ZexingGao/SeniorDesign/Supporting Documents/All Images/map.png

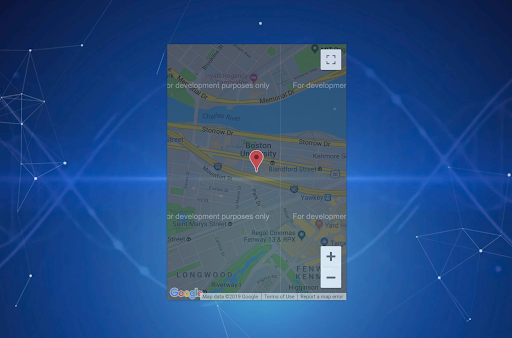
Supporting Documents/All Images/map.png
