ZexingGao/SeniorDesign/Supporting Documents/All Images/IMG_1205.JPG

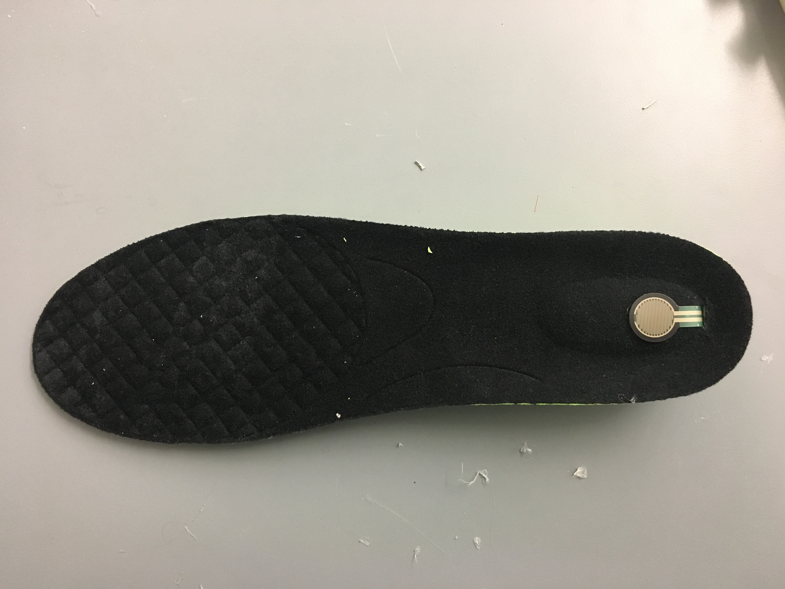
Supporting Documents/All Images/IMG_1205.JPG
