ZexingGao/SeniorDesign/Supporting Documents/Shark Tank Template.pptx

Running Safety

Safety with every Stride

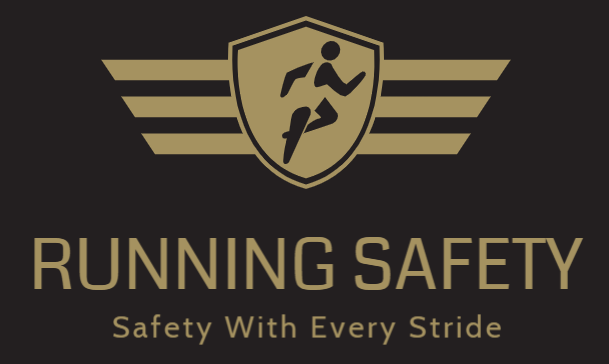
[picture p22: figure]

## Value Proposition

Who is this for?
Our product is design for night runner, especially women.
What does it provide?
The RunningSafety+ is a self-working device that provides it’s user safe running experience.
Advantage?
Unlike RunAngel, a bracelet that can send alert message by pressing the center button, RunningSafety+ can automatically detect danger and send out SOS messages without any action from the runner.

## Visualization

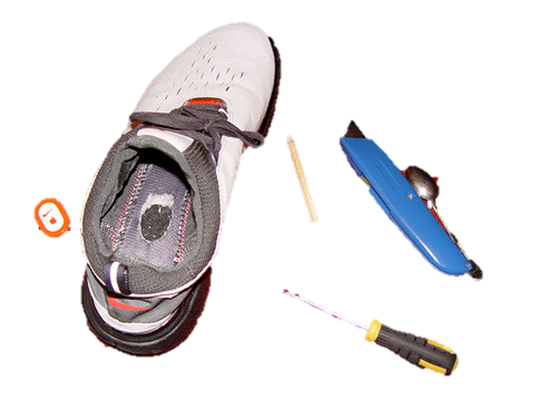
[picture p23: figure]

## Slide 4


GPS

## System

Hardware:

Distress Sensors (Accelerometer, Pulse Monitor)

Contained in bracelet

Software:
- Heat rate detection
- Interface for programmed emergency contact which can send message with GPS location.

GPS

μC

SMS

Contained in shoe

Bluetooth

μC

Notes: What is the pattern of heart rate? How to define a “dangerous situation ”

## Slide 6


Green: In-shoe Device
Yellow: Bracelet
Blue: Web App Front-End

## Running Safety Plus

A safety device that is comfortably concealed and fulfills all functions including track GPS coordinates, heart rate, the user’s pace, and contact an emergency contact.
With a rise in the amount of dangerous or health related emergencies that occur to young joggers, our device provides an efficient solution to help these cases.
What is Special about your product?
- Completely concealed and difficult to detect
- Requires no action from the user
- No sounding alarm, but immediately contacts a programmed emergency contact
Technology Solution
- Wristband and shoe insert with bluetooth communication
- Web Application for user interface with device

Notes: Note that sometimes you need more than one value proposition. For example if the beneficiary does not pay you, then you need one value proposition for your beneficiary and one for your paying customer.

## Thank you
