ZexingGao/SeniorDesign/Hardware/Schematic.pdf

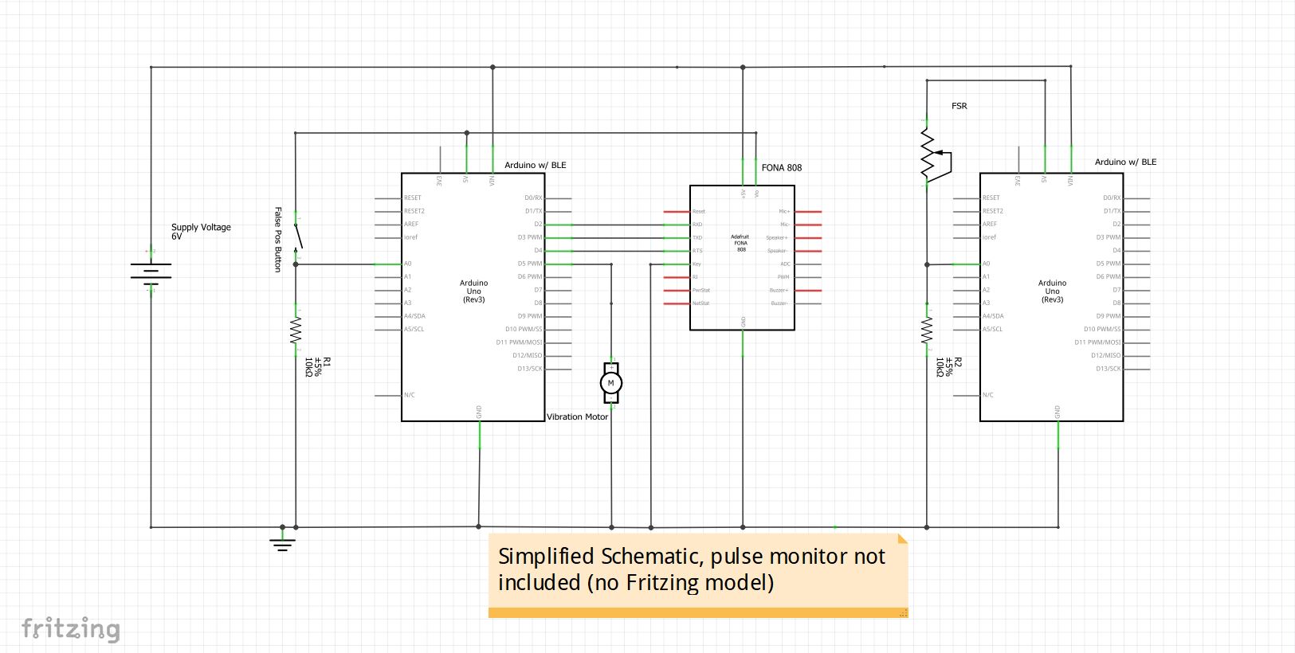
[picture p24: page 1]
