ZexingGao/SeniorDesign/Hardware/Arduino_Design.png

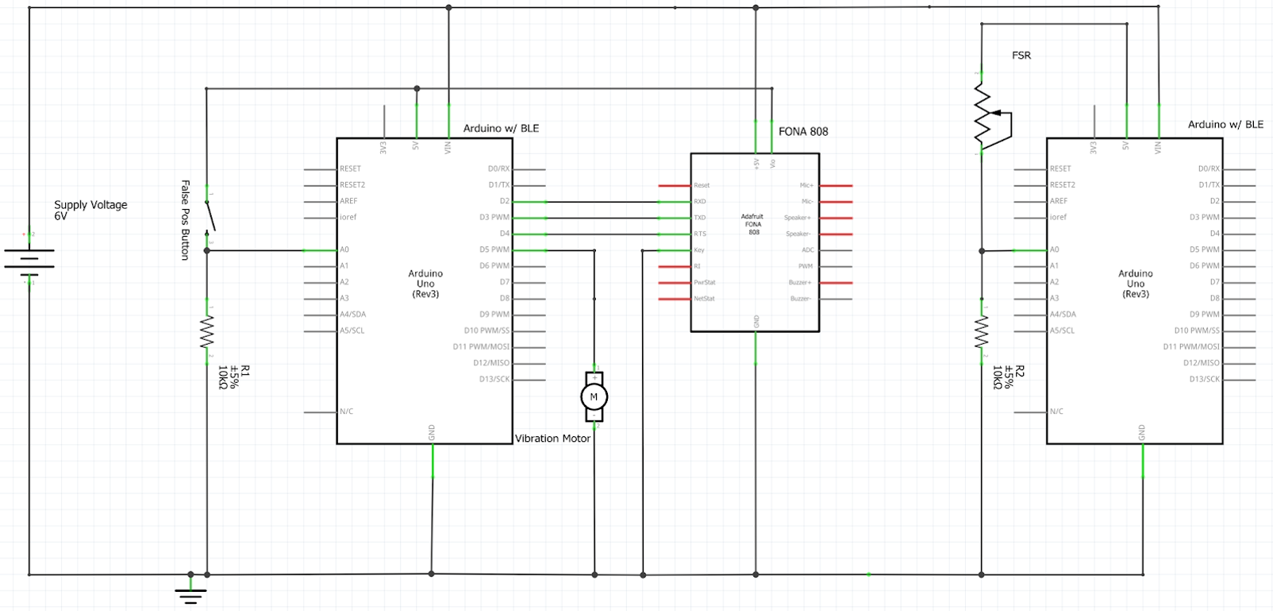
Hardware/Arduino_Design.png
