ZexingGao/SeniorDesign/Hardware/CAD_Case.png

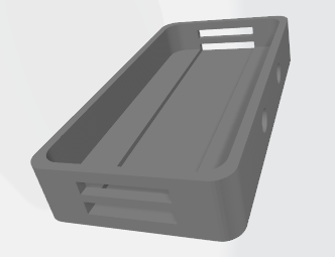
Hardware/CAD_Case.png
