ZexingGao/SeniorDesign/Supporting Documents/All Images/AWS1.png

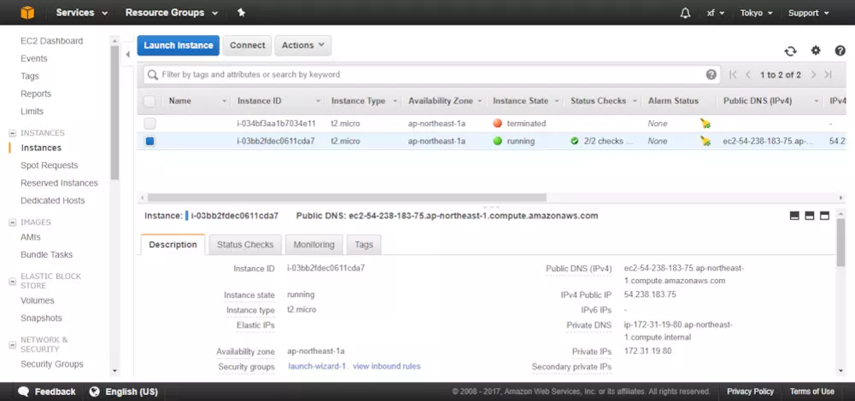
Supporting Documents/All Images/AWS1.png
