ZexingGao/SeniorDesign/Supporting Documents/All Images/AWS2.png

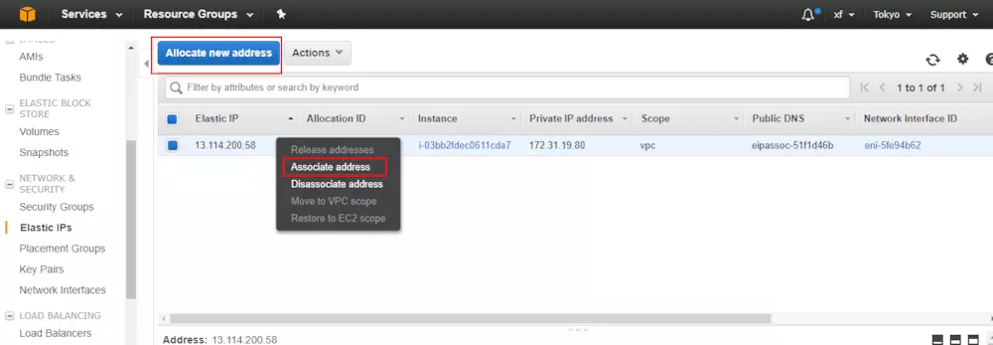
Supporting Documents/All Images/AWS2.png
