ZexingGao/SeniorDesign/Supporting Documents/All Images/AWS3.png

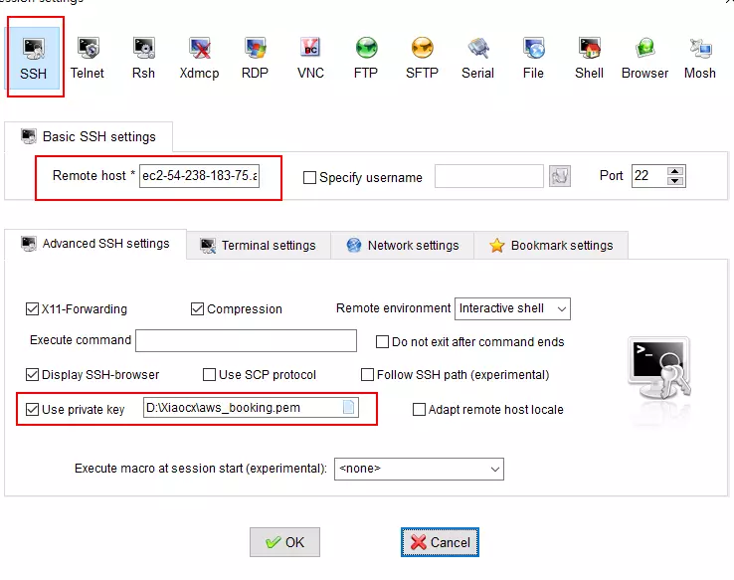
Supporting Documents/All Images/AWS3.png
