ZexingGao/SeniorDesign/Supporting Documents/All Images/Case Cover.jpg

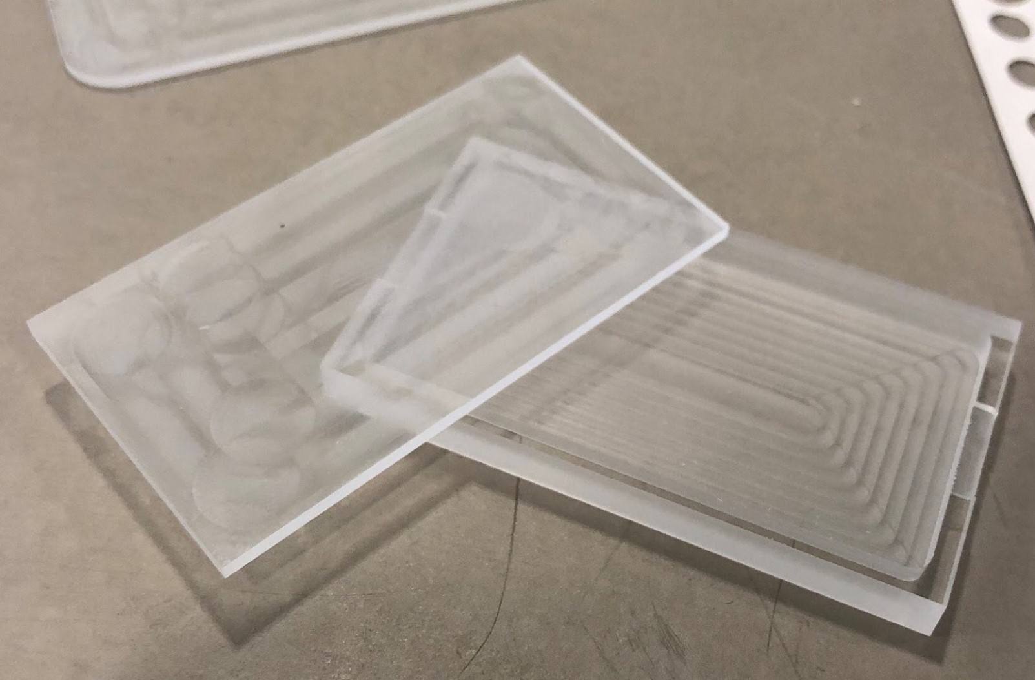
Supporting Documents/All Images/Case Cover.jpg
