ZexingGao/SeniorDesign/Supporting Documents/All Images/firebase2.png

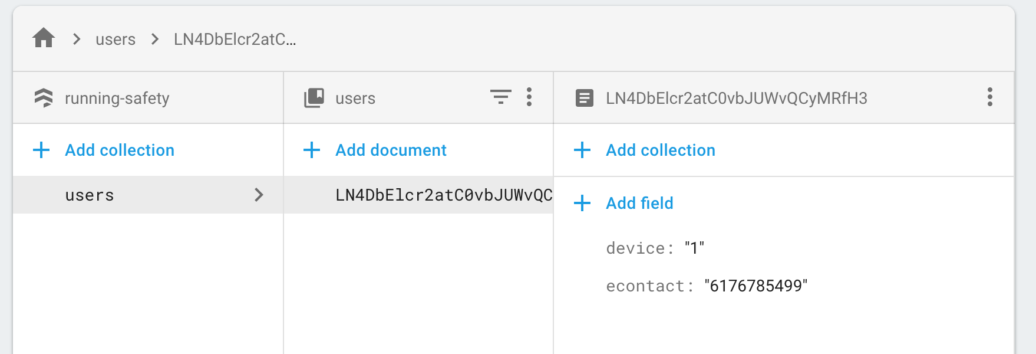
Supporting Documents/All Images/firebase2.png
