ZexingGao/SeniorDesign/Supporting Documents/All Images/firebase.png

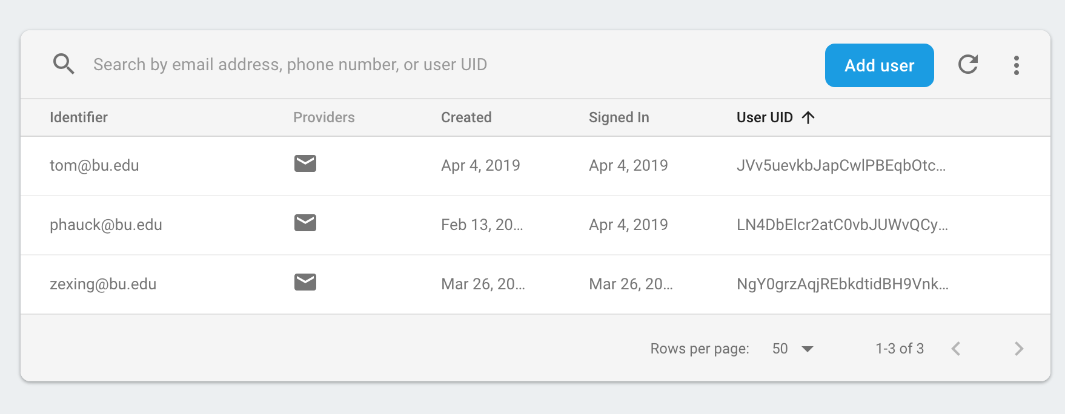
Supporting Documents/All Images/firebase.png
