ZexingGao/SeniorDesign/Supporting Documents/All Images/IMG_1206.JPG

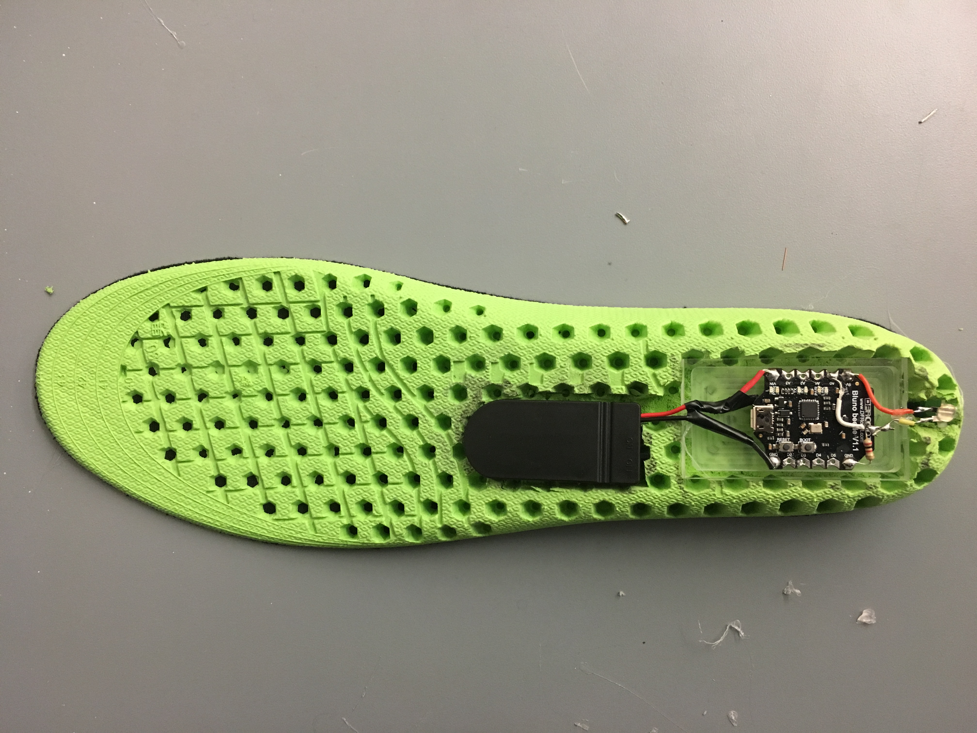
Supporting Documents/All Images/IMG_1206.JPG
