ZexingGao/SeniorDesign/Supporting Documents/All Images/IMG_1207.JPG

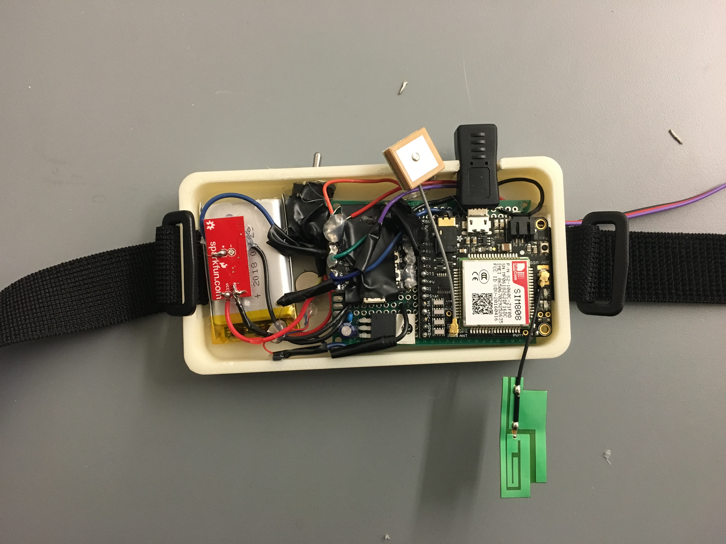
Supporting Documents/All Images/IMG_1207.JPG
