ZexingGao/SeniorDesign/Supporting Documents/All Images/Logic.png

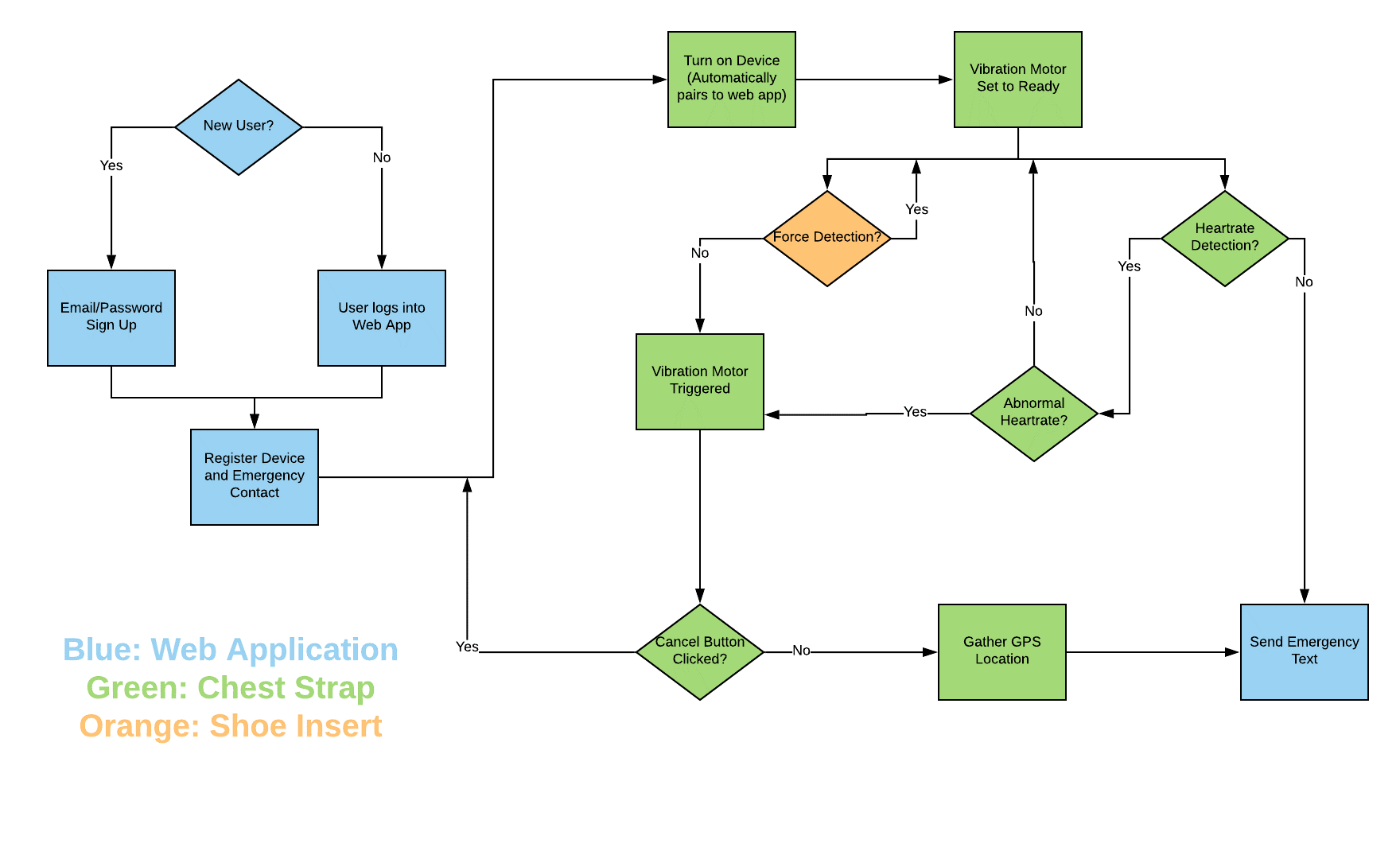
Supporting Documents/All Images/Logic.png
