ZexingGao/SeniorDesign/Supporting Documents/All Images/Login.png

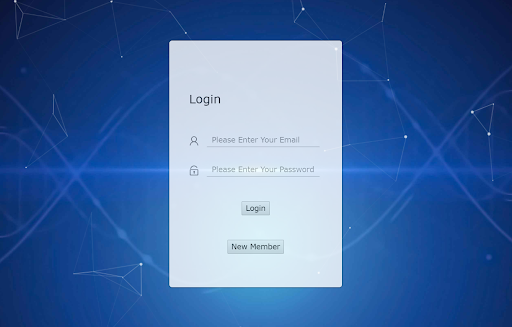
Supporting Documents/All Images/Login.png
