ZexingGao/SeniorDesign/Supporting Documents/All Images/sign-up.png

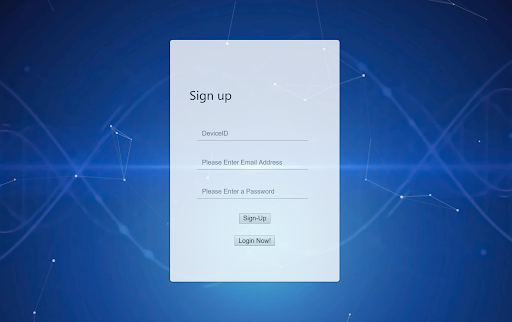
Supporting Documents/All Images/sign-up.png
