ZexingGao/SeniorDesign/Supporting Documents/All Images/text message.png

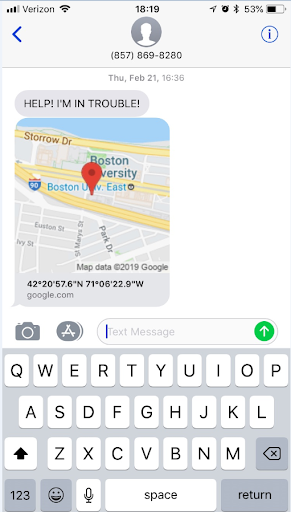
Supporting Documents/All Images/text message.png
