ZexingGao/SeniorDesign/Supporting Documents/All Images/Twilio.png

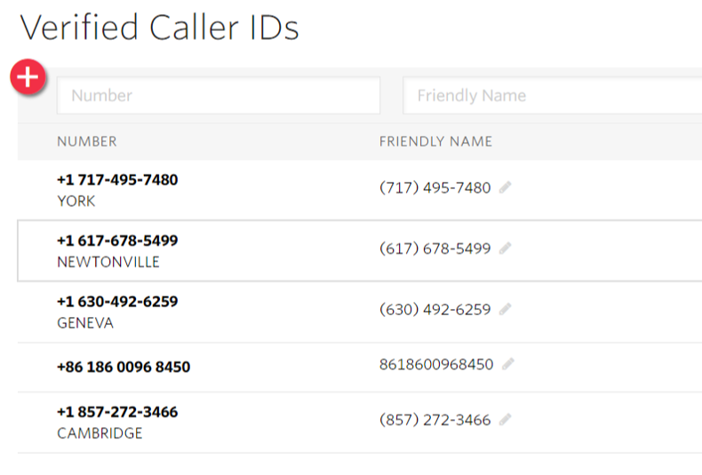
Supporting Documents/All Images/Twilio.png
